xonik/dist-noise-rm-pcb/distortion-noise-and-ring-modulator-v1.1-brd.md

# distortion-noise-and-ring-modulator-v1.1

### Board top
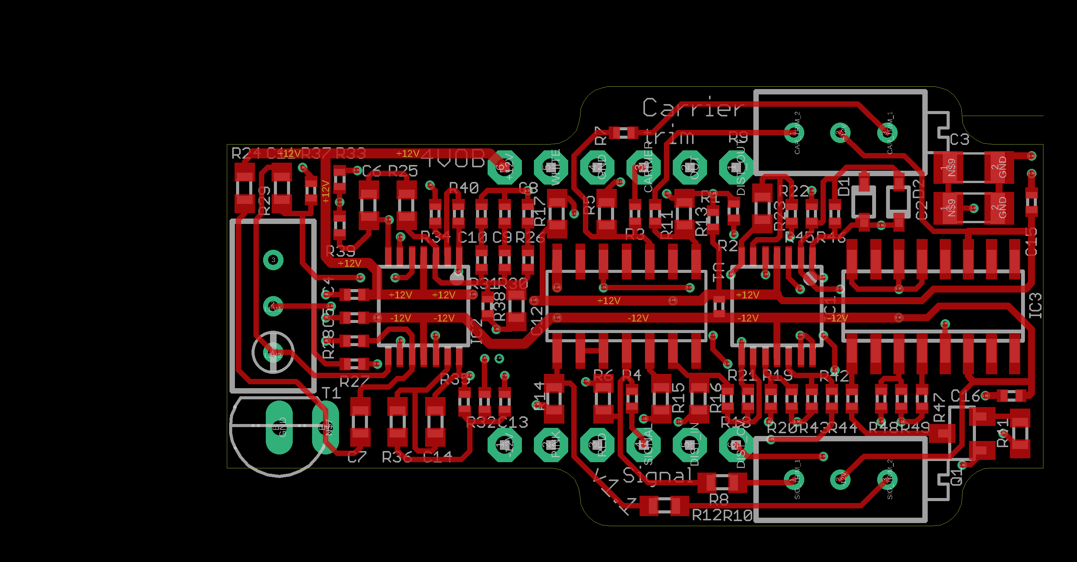
[picture p1: distortion-noise-and-ring-modulator-v1.1-brd-top.png]
Top side

### Board bottom
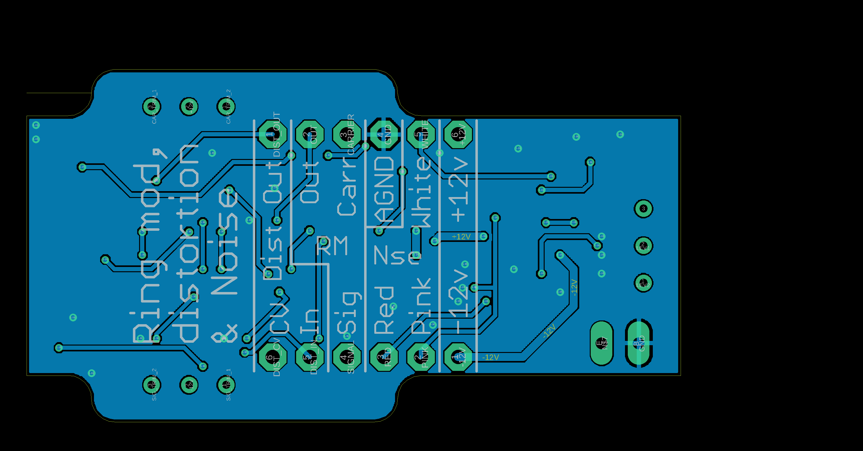
[picture p2: distortion-noise-and-ring-modulator-v1.1-brd-bottom.png]
Bottom side
