xonik/dist-noise-rm-pcb/distortion-noise-and-ring-modulator-v1.2-brd.md

# distortion-noise-and-ring-modulator-v1.2

### Board top
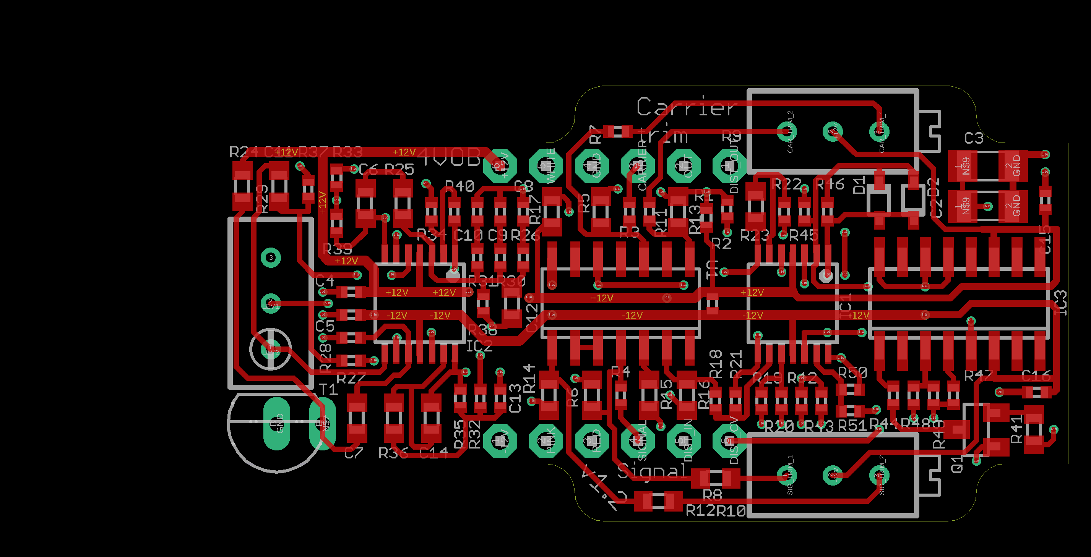
[picture p3: distortion-noise-and-ring-modulator-v1.2-brd-top.png]
Top side

### Board bottom
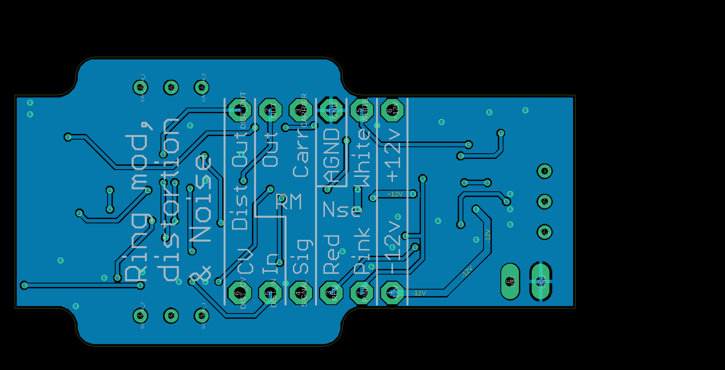
[picture p4: distortion-noise-and-ring-modulator-v1.2-brd-bottom.png]
Bottom side
