xonik/dist-noise-rm-pcb/distortion-noise-and-ring-modulator-v1.2-sch.md

# distortion-noise-and-ring-modulator-v1.2

### Sheet 1

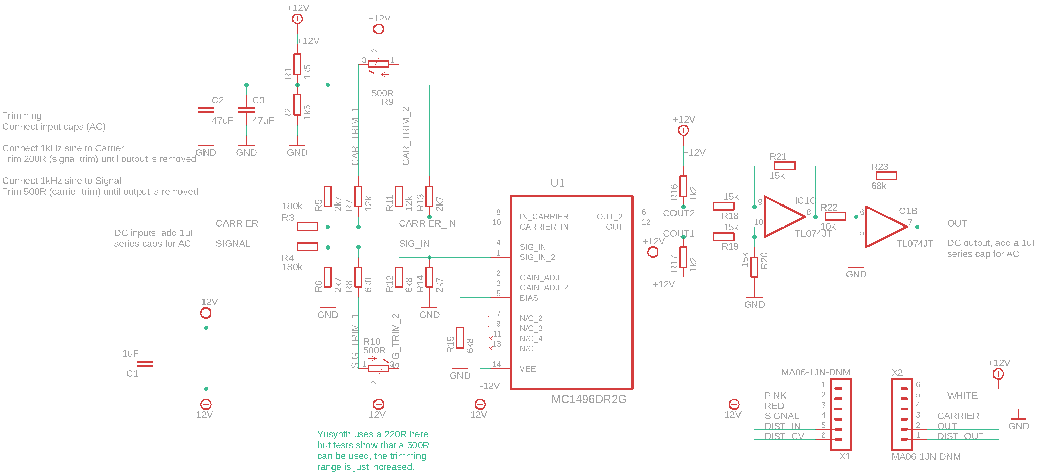
[picture p5: distortion-noise-and-ring-modulator-v1.2-sch-1.png]

### Sheet 2

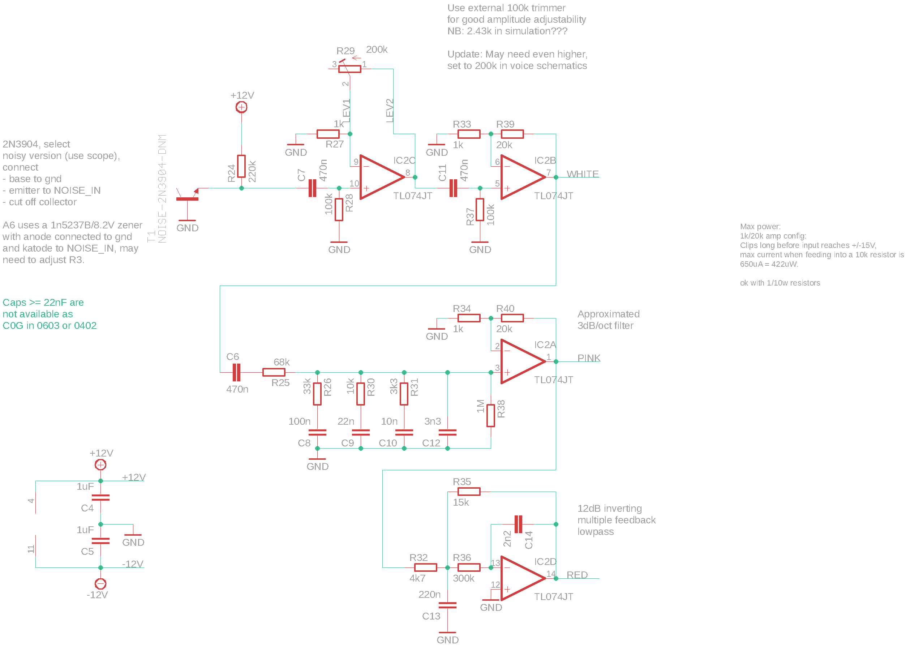
[picture p6: distortion-noise-and-ring-modulator-v1.2-sch-2.png]

### Sheet 3

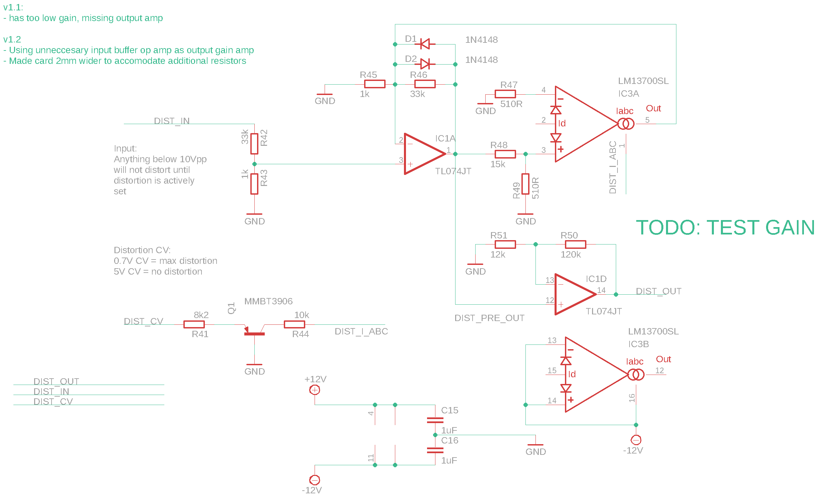
[picture p7: distortion-noise-and-ring-modulator-v1.2-sch-3.png]
