xonik/dist-noise-rm-pcb/distortion-noise-and-ring-modulator-v1.2.brd

## EAGLE design distortion-noise-and-ring-modulator-v1.2.brd (2025-08-10)

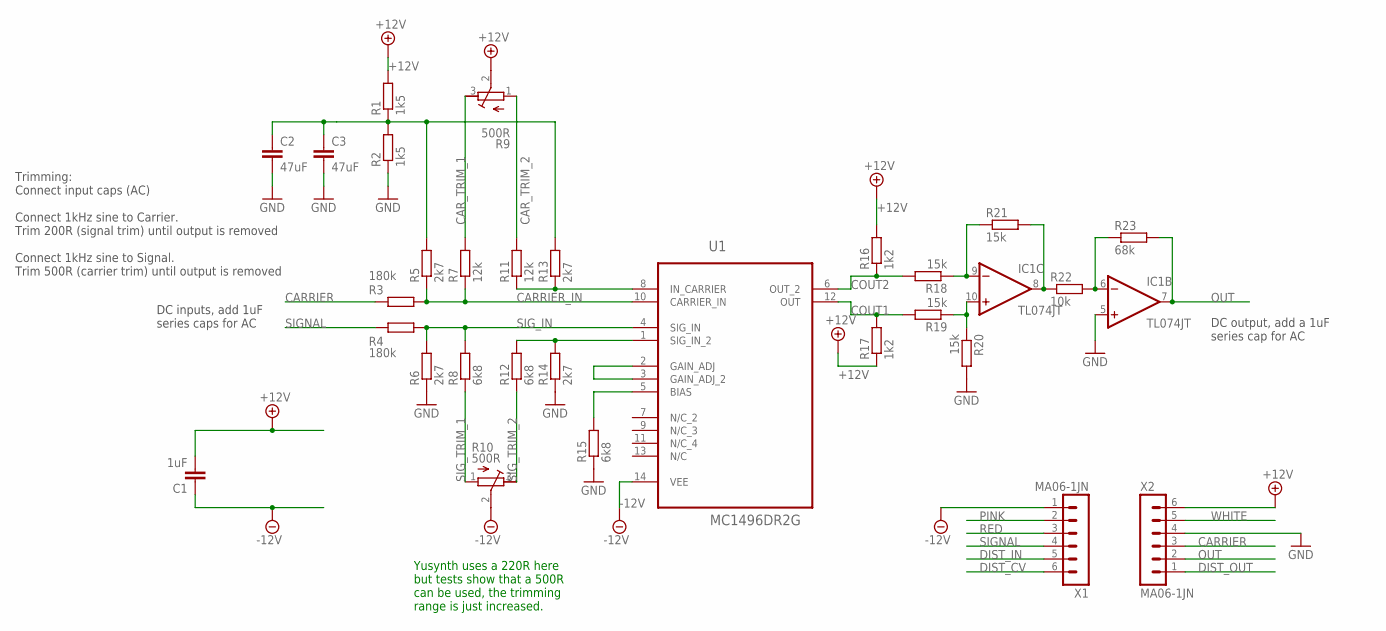
[picture p8: schematic distortion-noise-and-ring-modulator-v1.2.sch, sheet 1, Ring modulator]

Parts:
C1: 1uF; C0402-J
C2, C3: 47uF; C1206
IC1: TL074JT; TSSOP14J
R1, R2: 1k5; R0402
R3, R4: 180k; R0402
R5, R6, R13, R14: 2k7; R0603
R7, R11: 12k; R0402
R8, R12, R15: 6k8; R0603
R9, R10: 500R; RTRIM3296X
R16, R17: 1k2; R0603
R18, R19, R20, R21: 15k; R0402
R22: 10k; R0402
R23: 68k; R0603
U1: MC1496DR2G; SOIC127P600X175-14N
X1, X2: MA06-1JN; MA06N-1J

Connections:
+12V: C1.2, R1.2, R9.2 (S), R16.2, R17.1, X2.6; also elsewhere on the board
-12V: C1.1, R10.2 (S), U1.14 (VEE), X1.1; also elsewhere on the board
CARRIER: R3.1, X2.3
CARRIER_IN: R3.2, R5.1, R7.1, U1.10 (CARRIER_IN)
CAR_TRIM_1: R7.2, R9.3 (E)
CAR_TRIM_2: R9.1 (A), R11.2
COUT1: R17.2, R19.2, U1.12 (OUT)
COUT2: R16.1, R18.2, U1.6 (OUT_2)
DIST_CV: X1.6; also elsewhere on the board
DIST_IN: X1.5; also elsewhere on the board
DIST_OUT: X2.1; also elsewhere on the board
GND: C2.2, C3.2, IC1.5 (+IN), R2.1, R6.1, R14.1, R15.1, R20.2, X2.4; also elsewhere on the board
unnamed: R12.2, R14.2, U1.1 (SIG_IN_2)
unnamed: R11.1, R13.1, U1.8 (IN_CARRIER)
unnamed: C2.1, C3.1, R1.1, R2.2, R5.2, R13.2
unnamed: R15.2, U1.5 (BIAS)
unnamed: U1.2 (GAIN_ADJ), U1.3 (GAIN_ADJ_2)
unnamed: IC1.10 (+IN), R19.1, R20.1
unnamed: IC1.9 (-IN), R18.1, R21.1
unnamed: IC1.8 (OUT), R21.2, R22.1
unnamed: IC1.6 (-IN), R22.2, R23.1
OUT: IC1.7 (OUT), R23.2, X2.2
PINK: X1.2; also elsewhere on the board
RED: X1.3; also elsewhere on the board
SIGNAL: R4.1, X1.4
SIG_IN: R4.2, R6.2, R8.2, U1.4 (SIG_IN)
SIG_TRIM_1: R8.1, R10.1 (A)
SIG_TRIM_2: R10.3 (E), R12.1
WHITE: X2.5; also elsewhere on the board

Notes on the sheet:
DC inputs, add 1uF series caps for AC
DC output, add a 1uF series cap for AC
Trimming: Connect input caps (AC) Connect 1kHz sine to Carrier. Trim 200R (signal trim) until output is removed Connect 1kHz sine to Signal. Trim 500R (carrier trim) until output is removed
Yusynth uses a 220R here but tests show that a 500R can be used, the trimming range is just increased.

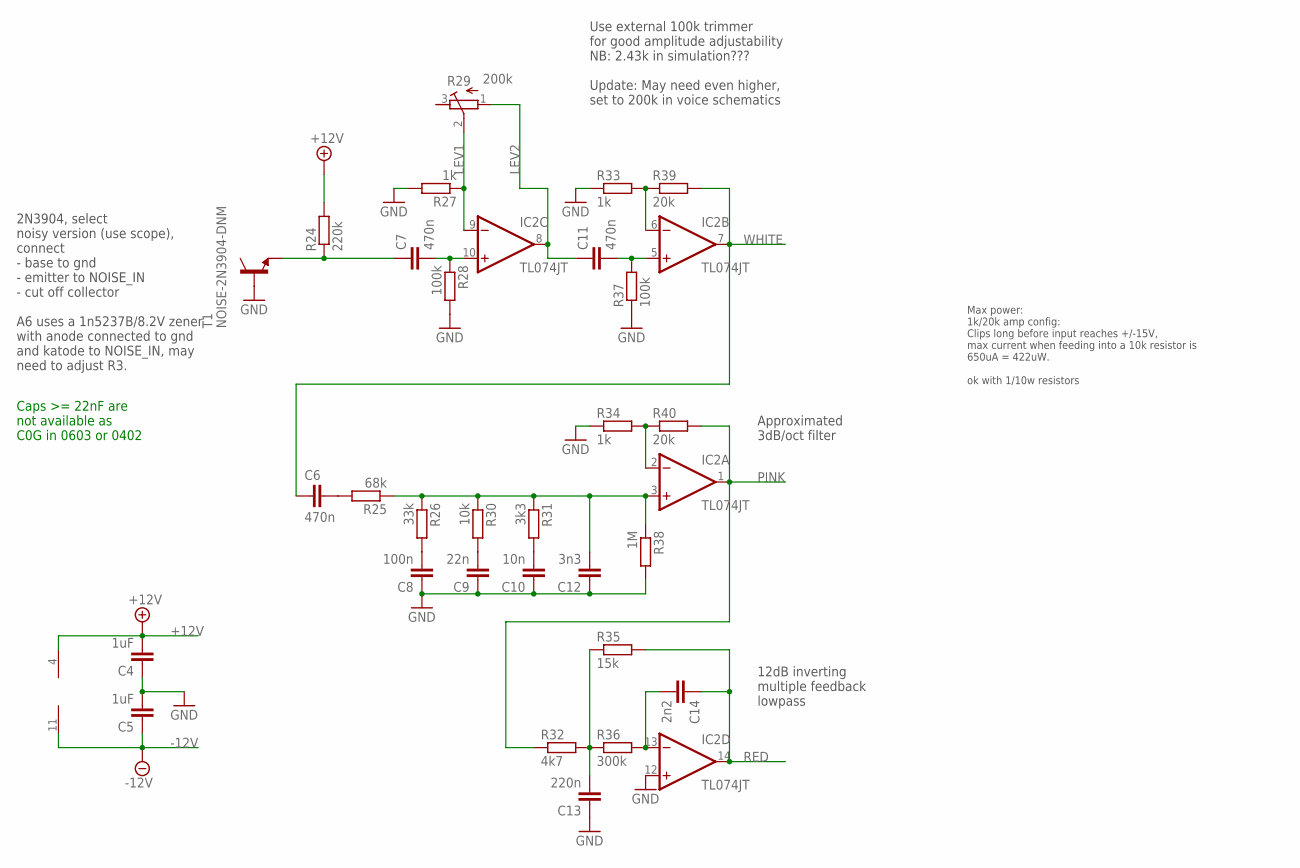
[picture p9: schematic distortion-noise-and-ring-modulator-v1.2.sch, sheet 2, Noise]

Parts:
C4, C5: 1uF; C0402-J
C6, C7, C11: 470n; C0603-J
C8: 100n; C0402-J
C9: 22n; C0402-J
C10: 10n; C0402-J
C12: 3n3; C0603-J
C13: 220n; C0402-J
C14: 2n2; C0603-J
IC2: TL074JT; TSSOP14J
R24: 220k; R0603
R25: 68k; R0603
R26: 33k; R0402
R27, R33, R34: 1k; R0402
R28, R37: 100k; R0402
R29: 200k; RTRIM3296W
R30: 10k; R0402
R31: 3k3; R0402
R32: 4k7; R0402
R35: 15k; R0402
R36: 300k; R0603
R38: 1M; R0402
R39, R40: 20k; R0402
T1: NOISE-2N3904-DNM; NOISE-2N3904-J

Connections:
+12V: C4.2, IC2.4 (V+), R24.2; also elsewhere on the board
-12V: C5.1, IC2.11 (V-); also elsewhere on the board
GND: C4.1, C5.2, C8.1, C9.1, C10.1, C12.1, C13.1, IC2.12 (+IN), R27.2, R28.2, R33.1, R34.1, R37.1, R38.2, T1.B; also elsewhere on the board
LEV1: IC2.9 (-IN), R27.1, R29.2 (S)
LEV2: C11.1, IC2.8 (OUT), R29.1 (A)
unnamed: IC2.2 (-IN), R34.2, R40.1
unnamed: IC2.6 (-IN), R33.2, R39.1
unnamed: C8.2, R26.2
unnamed: C9.2, R30.2
unnamed: C10.2, R31.2
unnamed: C7.1, R24.1, T1.E
unnamed: C7.2, IC2.10 (+IN), R28.1
unnamed: C11.2, IC2.5 (+IN), R37.2
unnamed: C12.2, IC2.3 (+IN), R25.1, R26.1, R30.1, R31.1, R38.1
unnamed: C6.2, R25.2
unnamed: C13.2, R32.2, R35.1, R36.1
unnamed: C14.2, IC2.13 (-IN), R36.2
PINK: IC2.1 (OUT), R32.1, R40.2; also elsewhere on the board
RED: C14.1, IC2.14 (OUT), R35.2; also elsewhere on the board
WHITE: C6.1, IC2.7 (OUT), R39.2; also elsewhere on the board

Notes on the sheet:
Use external 100k trimmer for good amplitude adjustability NB: 2.43k in simulation??? Update: May need even higher, set to 200k in voice schematics
Approximated 3dB/oct filter
12dB inverting multiple feedback lowpass
2N3904, select noisy version (use scope), connect - base to gnd - emitter to NOISE_IN - cut off collector A6 uses a 1n5237B/8.2V zener with anode connected to gnd and katode to NOISE_IN, may need to adjust R3.
Max power: 1k/20k amp config: Clips long before input reaches +/-15V, max current when feeding into a 10k resistor is 650uA = 422uW. ok with 1/10w resistors
Caps >= 22nF are not available as C0G in 0603 or 0402

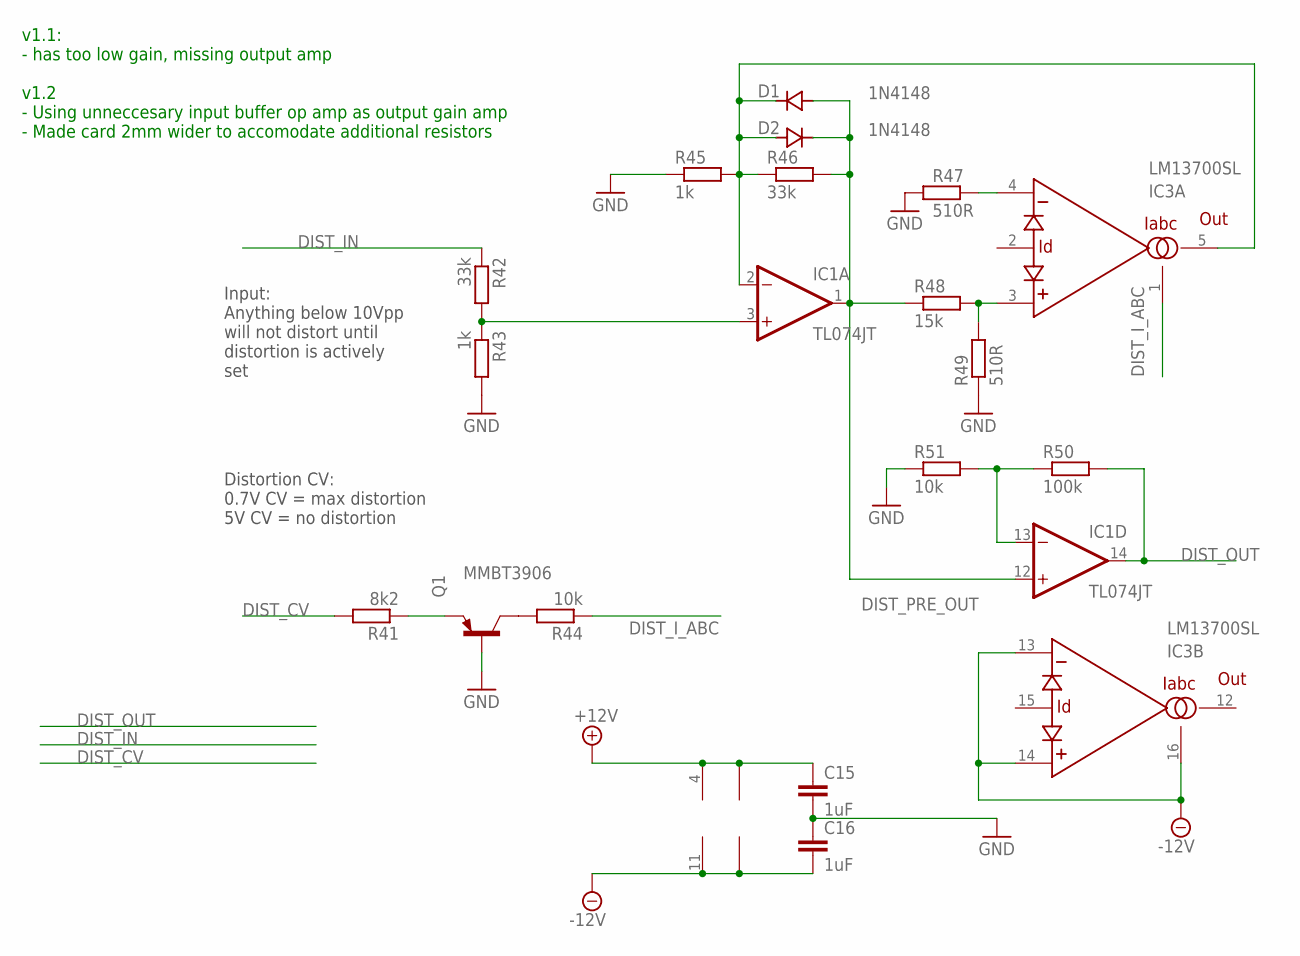
[picture p10: schematic distortion-noise-and-ring-modulator-v1.2.sch, sheet 3, Distortion]

Parts:
C15, C16: 1uF; C0402-J
D1, D2: 1N4148; SOD323J
IC1: TL074JT; TSSOP14J
IC3: LM13700SL; SO16-NARROW-J
Q1: MMBT3906; SOT23-BEC
R41: 8k2; R0603
R42, R46: 33k; R0402
R43, R45: 1k; R0402
R44, R51: 10k; R0402
R47, R49: 510R; R0402
R48: 15k; R0402
R50: 100k; R0402

Connections:
+12V: C15.1, IC1.4 (V+), IC3.11 (V+); also elsewhere on the board
-12V: C16.2, IC1.11 (V-), IC3.6 (V-), IC3.13 (-IN), IC3.14 (+IN), IC3.16 (IABC); also elsewhere on the board
DIST_CV: R41.2; also elsewhere on the board
DIST_IN: R42.1; also elsewhere on the board
DIST_I_ABC: IC3.1 (IABC), R44.1
DIST_OUT: IC1.14 (OUT), R50.2; also elsewhere on the board
DIST_PRE_OUT: D1.2 (A), D2.1 (C), IC1.1 (OUT), IC1.12 (+IN), R46.2, R48.1
GND: C15.2, C16.1, Q1.B, R43.2, R45.1, R47.1, R49.1, R51.1; also elsewhere on the board
unnamed: IC1.3 (+IN), R42.2, R43.1
unnamed: IC1.13 (-IN), R50.1, R51.2
unnamed: D1.1 (C), D2.2 (A), IC1.2 (-IN), IC3.5 (OUT), R45.2, R46.1
unnamed: IC3.4 (-IN), R47.2
unnamed: IC3.3 (+IN), R48.2, R49.2
unnamed: Q1.E, R41.1
unnamed: Q1.C, R44.2

Notes on the sheet:
Distortion CV: 0.7V CV = max distortion 5V CV = no distortion
Input: Anything below 10Vpp will not distort until distortion is actively set
v1.1: - has too low gain, missing output amp v1.2 - Using unneccesary input buffer op amp as output gain amp - Made card 2mm wider to accomodate additional resistors

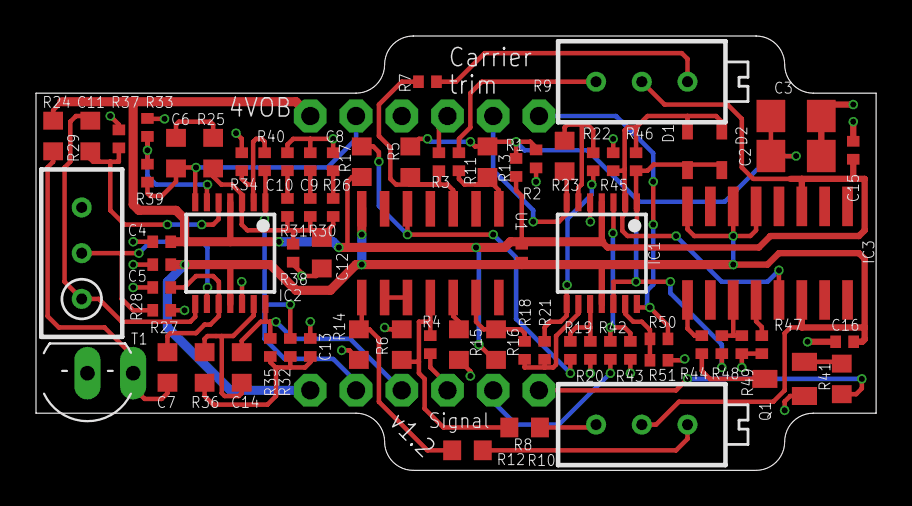
[picture p11: board distortion-noise-and-ring-modulator-v1.2.brd from above]

Board: 2 copper layers, 46.7 x 24.1 mm, 77 parts (0 on the bottom side), 52 nets.
