xonik/dist-noise-rm-pcb/(commit log)

2025-01-01 Moved multi-fx to separate repo
    [distortion-noise-and-ring-modulator-v1.1.brd, distortion-noise-and-ring-modulator-v1.1.sch, distortion-noise-and-ring-modulator-v1.1_top_bom.csv, distortion-noise-and-ring-modulator-v1.1_top_bom_populated.csv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]
2025-05-18 Routed v1.2
    [distortion-noise-and-ring-modulator-v1.2.brd, distortion-noise-and-ring-modulator-v1.2.sch]
2025-05-18 Adjust silk screen
    [distortion-noise-and-ring-modulator-v1.2.brd]
2025-05-18 Tested and ready for production
    [distortion-noise-and-ring-modulator-v1.2.brd, distortion-noise-and-ring-modulator-v1.2.sch]
2025-08-10 Tested bom and gerber, v1.2
    [distortion-noise-and-ring-modulator-v1.2.brd, distortion-noise-and-ring-modulator-v1.2.sch, distortion-noise-and-ring-modulator-v1.2_top_bom.csv, distortion-noise-and-ring-modulator-v1.2_top_bom_populated.csv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]
